Aleexuta/S4ndHunt3rs-Romanian-CanSat-and-Rocketry-Competition-2023/imageSource/bmp280.png

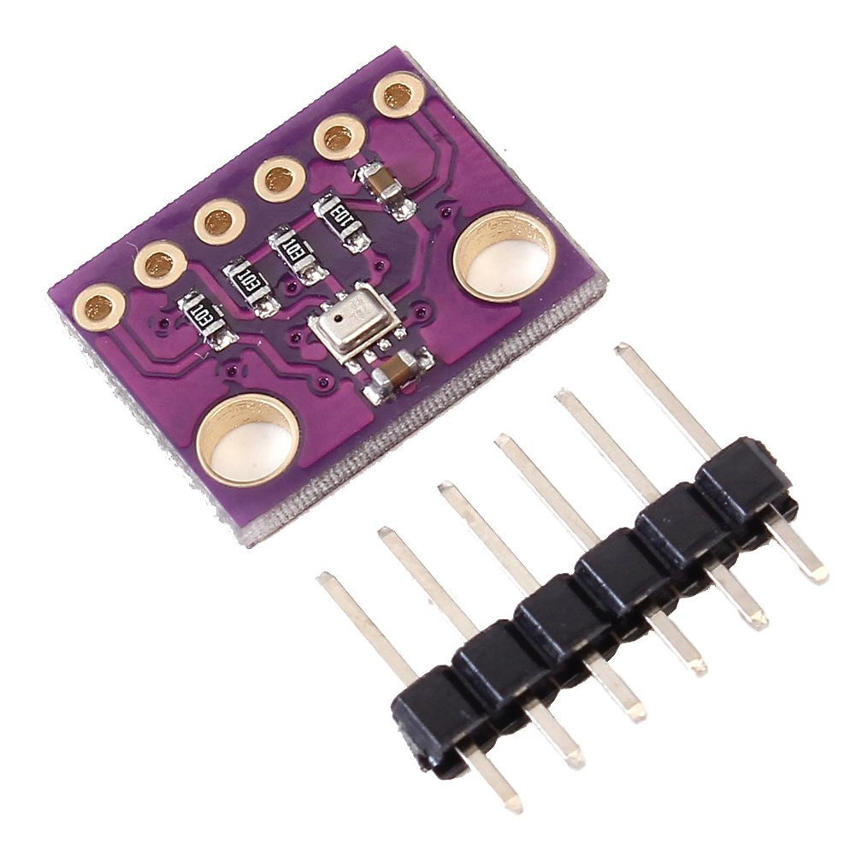
imageSource/bmp280.png
