Aleexuta/S4ndHunt3rs-Romanian-CanSat-and-Rocketry-Competition-2023/imageSource/cansat2_final.jpg

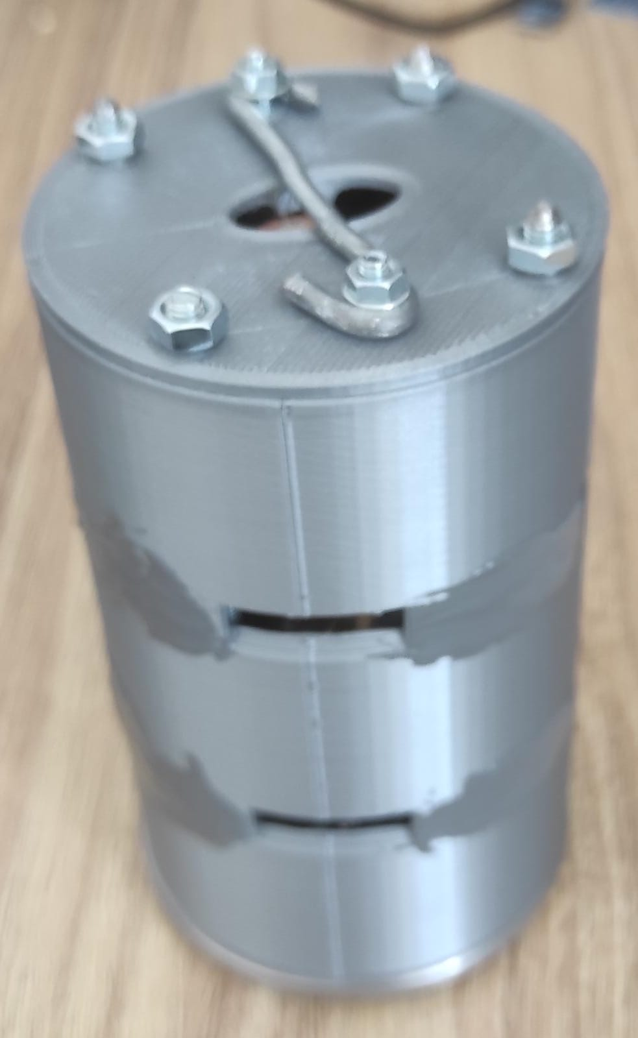
imageSource/cansat2_final.jpg
