Aleexuta/S4ndHunt3rs-Romanian-CanSat-and-Rocketry-Competition-2023/README.md

# S4ndHunt3rs-Romanian-CanSat-and-Rocketry-Competition-2023
Team S4ndHunt3rs of Romanian CanSat and Rocketry Competition 2023

We built a CanSat that capture land images used for detecting agricultural fields and track changes from one launch to another.
We won the "Highest Technical Achievement" and 
3rd place in the Collaborative European Research Conference 2023.
