Aleexuta/S4ndHunt3rs-Romanian-CanSat-and-Rocketry-Competition-2023/imageSource/cansat1_final.jpg

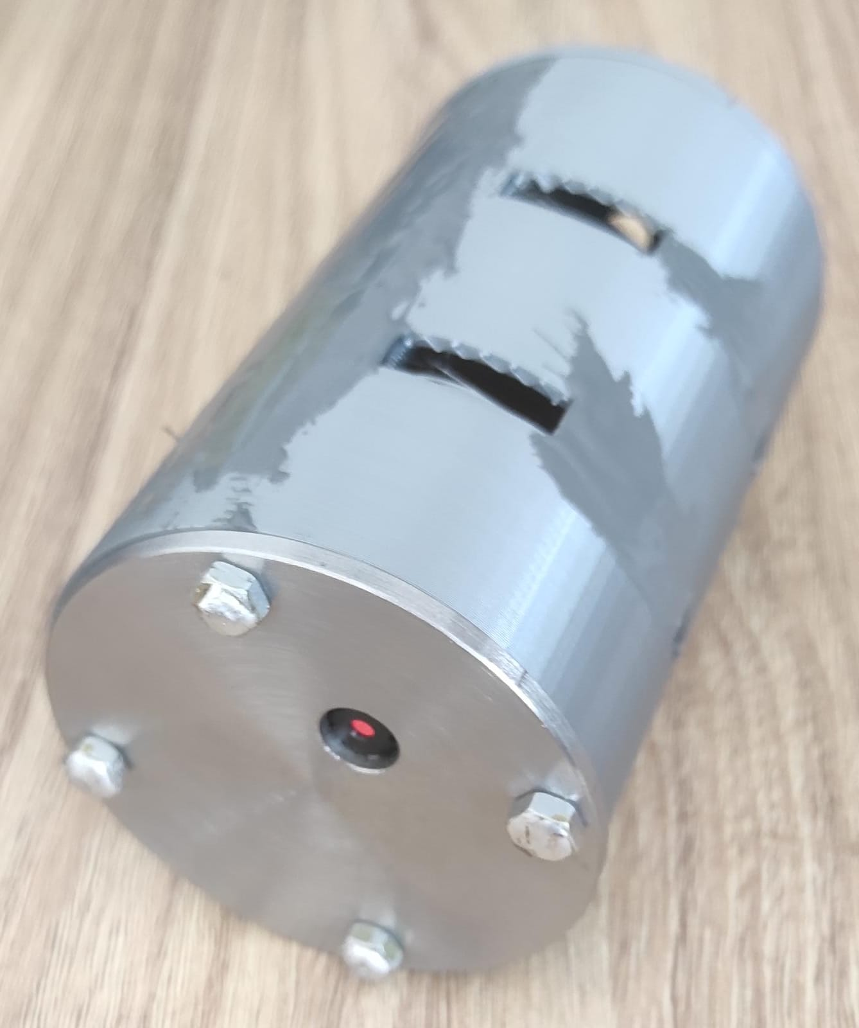
imageSource/cansat1_final.jpg
