Aleexuta/S4ndHunt3rs-Romanian-CanSat-and-Rocketry-Competition-2023/imageSource/electric_block_detailed.png

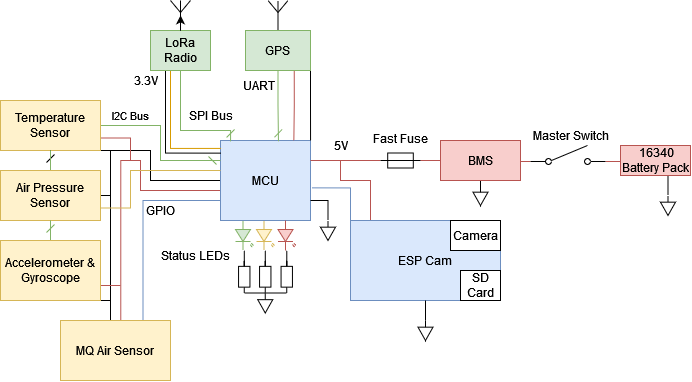
imageSource/electric_block_detailed.png
