Aleexuta/S4ndHunt3rs-Romanian-CanSat-and-Rocketry-Competition-2023/imageSource/FSM all details.png

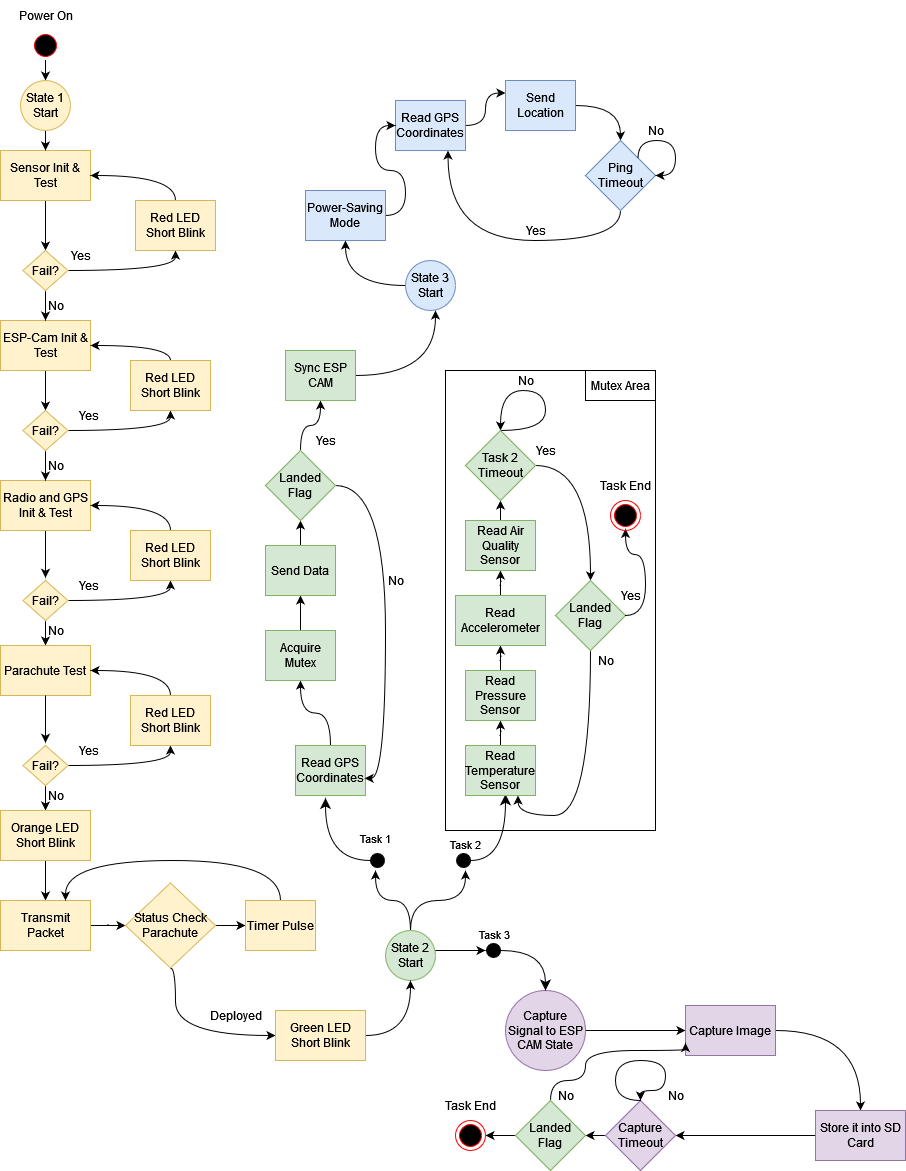
imageSource/FSM all details.png
