Aleexuta/S4ndHunt3rs-Romanian-CanSat-and-Rocketry-Competition-2023/imageSource/gy-neo6mv2.png

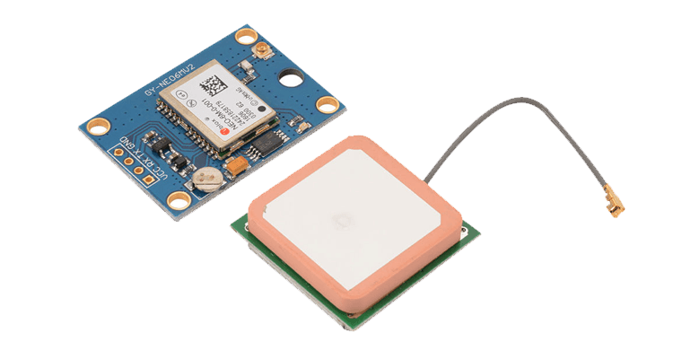
imageSource/gy-neo6mv2.png
