Aleexuta/S4ndHunt3rs-Romanian-CanSat-and-Rocketry-Competition-2023/imageSource/mq135.jpg

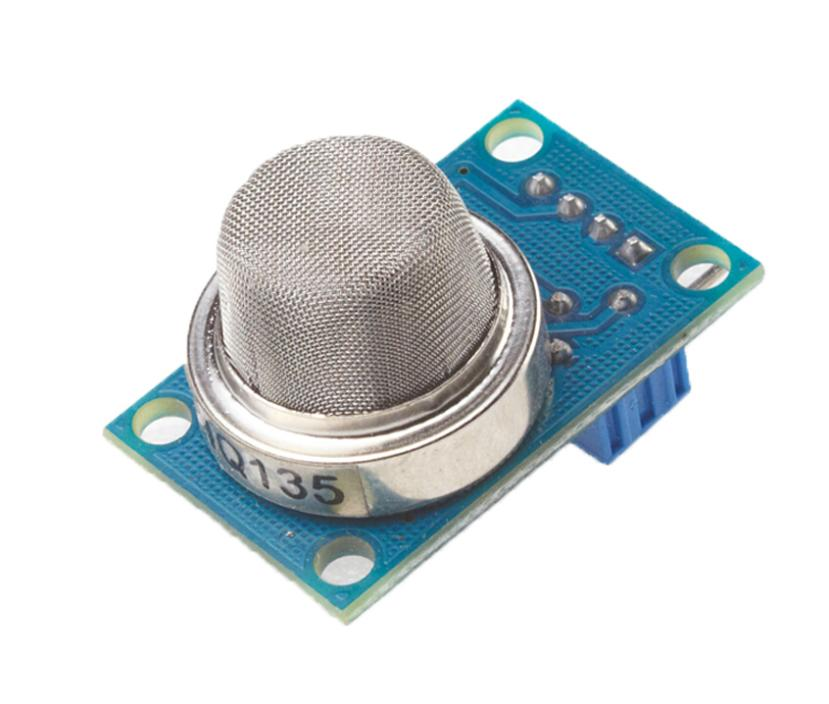
imageSource/mq135.jpg
