Aleexuta/S4ndHunt3rs-Romanian-CanSat-and-Rocketry-Competition-2023/imageSource/rfm95W.jpg

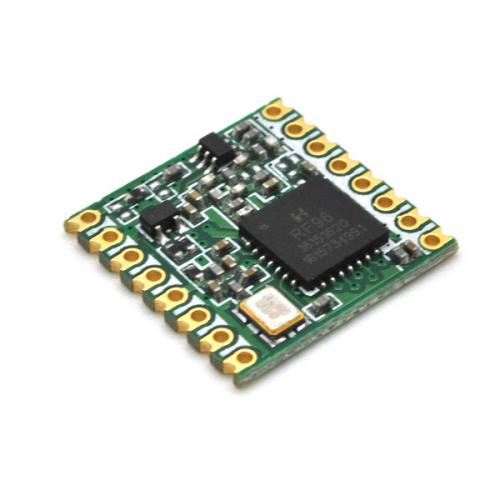
imageSource/rfm95W.jpg
