Aleexuta/S4ndHunt3rs-Romanian-CanSat-and-Rocketry-Competition-2023/Simmulation and graphs/graphics/temperature.png

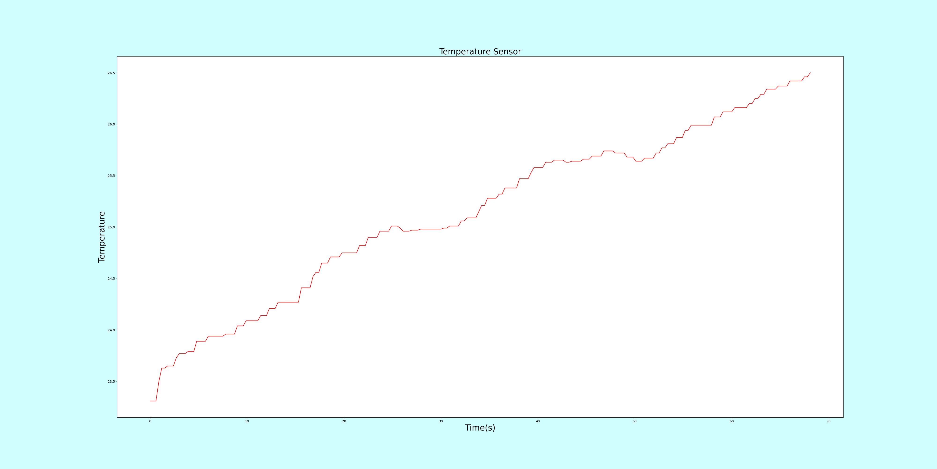
Simmulation and graphs/graphics/temperature.png
