Aleexuta/S4ndHunt3rs-Romanian-CanSat-and-Rocketry-Competition-2023/Microcontroller Code/CanSat/CanSat.ino

#include <TinyGPS++.h>
#include <Wire.h>
#include <AHTxx.h>
#include <Adafruit_BMP280.h>
#include <Adafruit_MPU6050.h>
#include <Adafruit_Sensor.h>
#include <SPI.h>
#include <LoRa.h>

#include "esp_config.h"

#define ss 5
#define rst 14
#define dio0 2

#define MQ_PIN 35

AHTxx aht10(AHTXX_ADDRESS_X38, AHT1x_SENSOR);
TinyGPSPlus gps;
Adafruit_BMP280 bmp;
Adafruit_MPU6050 mpu;

unsigned long dataTimerPrevious = 0;
unsigned long cameraTimerStart = 0;
const unsigned long interval = 2000; // 2 seconds
bool receiveData = true;

extern double ahtTemp;
extern double ahtHum;
extern double bmpTemp;
extern double bmpPres;
extern double bmpAlt;
extern double mpuAX, mpuAY, mpuAZ;
extern double mpuGX, mpuGY, mpuGZ;
extern double mpuTemp;
extern double gpsLat;
extern double gpsLong;
extern double gpsSpeed;
extern double gpsAlt;
extern double mqData;
extern uint32_t packetCounter;
extern uint8_t hash;

void setup() {

#if DEBUG
  // Serial communication to PC for debugging
  Serial.begin(115200);
#endif
  // Serial communication to ESP CAM and GPS
  Serial2.begin(9600);
  Wire.begin();

  loraSetup();
  ahtSetup();
  bmpSetup();
  mpuSetup();
  cameraTimerStart = millis();
}

void loop() {
  unsigned long dataTimerCurrent = millis();
  unsigned long cameraTimerTimeout = millis();

  checkCameraTimeout(cameraTimerTimeout);

    // Check if 2 seconds have passed
  if (dataTimerCurrent - dataTimerPrevious >= interval) {
    // Reset the timer
    dataTimerPrevious = dataTimerCurrent;
    debug_println("2 seconds have passed");
    receiveData = true;
  }

  if (receiveData) {
    recvAHTData();
    recvBMPData();
    
    receiveData = false;
  }
  recvGPSData();
  recvMPUData();
  recvMQData();
  
  hashCompute();
  sendLoraData();
  delay(10);
}

void checkCameraTimeout(unsigned long cameraTimerTimeout)
{
  unsigned long elapsedTime = (cameraTimerTimeout - cameraTimerStart) / 60000;

  if (elapsedTime > 120)
  {
      Serial2.println('s');
      debug_println("Stopped camera by timeout");
  }
  else if (elapsedTime > 25)
  {
    if (gpsAlt < 600)
    {
      Serial2.println('s');
      debug_println("Stopped camera by altitude timeout");
    }
  }
}

void hashCompute()
{
  hash = ahtTemp + ahtHum + bmpTemp + bmpPres + bmpAlt + \
  mpuAX + mpuAY + mpuAZ + mpuGX + mpuGY + mpuGZ + mpuTemp + \
  gpsSpeed + gpsAlt + gpsLat + gpsLong + \
  mqData;

  hash = hash % 0xFF;

}
