Aleexuta/S4ndHunt3rs-Romanian-CanSat-and-Rocketry-Competition-2023/Microcontroller Code/Ground Station/ground_station/ground_station.ino

#include <SPI.h>
#include <LoRa.h>

//define the pins used by the transceiver module
#define ss 5
#define rst 14
#define dio0 2

uint8_t hash;
double ahtTemp;
double ahtHum;
double bmpTemp;
double bmpPres;
double bmpAlt;
double mpuAX, mpuAY, mpuAZ;
double mpuGX, mpuGY, mpuGZ;
double mpuTemp;
double gpsLat;
double gpsLong;
double gpsSpeed;
double gpsAlt;
double mqData;

void setup() {
  //initialize Serial Monitor
  Serial.begin(115200);
  while (!Serial);
  Serial.println("LoRa Receiver");

  //setup LoRa transceiver module
  LoRa.setPins(ss, rst, dio0);
  
  //replace the LoRa.begin(---E-) argument with your location's frequency 
  //433E6 for Asia
  //866E6 for Europe
  //915E6 for North America
  while (!LoRa.begin(866E6)) {
    Serial.println(".");
    delay(500);
  }
   // Change sync word (0xF3) to match the receiver
  // The sync word assures you don't get LoRa messages from other LoRa transceivers
  // ranges from 0-0xFF
  LoRa.setSyncWord(0xF3);
  Serial.println("LoRa Initializing OK!");
}

void loop() {
  // try to parse packet
  int packetSize = LoRa.parsePacket();
  if (packetSize) {
    // received a packet
    Serial.print("Received packet '");

    // read packet
    while (LoRa.available()) {
      String LoRaData = LoRa.readString();
      Serial.print(LoRaData); 
    }

    // print RSSI of packet
    Serial.print("' with RSSI ");
    Serial.println(LoRa.packetRssi());
  }
}

void hashCompute()
{
  hash = ahtTemp + ahtHum + bmpTemp + bmpPres + bmpAlt + \
  mpuAX + mpuAY + mpuAZ + mpuGX + mpuGY + mpuGZ + mpuTemp + \
  gpsSpeed + gpsAlt + gpsLat + gpsLong + \
  mqData;

  hash = hash % 0xFF;

}
