Aleexuta/S4ndHunt3rs-Romanian-CanSat-and-Rocketry-Competition-2023/(commit log)

2023-03-11 Added module code
    Fixed BMP, GPS and added MPU
    [CanSat.ino, esp_aht.ino, esp_gps.ino, esp_mpu.ino]
2023-04-24 Modified normal prints to debug prints
2023-04-29 MQ135 sensor added
2023-04-29 Ammended prints
2023-05-05 Added camera deepsleep
